finnhittson/ee308/lab1/output amplifier.asc

C1: cap; .8p
C2: cap; 20n
C3: cap; 20n
C4: cap; 600p
C5: cap; 47p
D1: diode; 1N4148
D2: diode; 1N4148
Q1: npn; 2N3904
Q2: npn; 2N3904
Q3: pnp; 2N3906
Q6: npn; 2N3904
Q9: pnp; 2N3906
R1: res; 750
R2: res; {pos+1}
R3: res; 50
R4: res; 50
R5: res; 5k
R6: res; 723
R7: res; 13k
R8: res; 1k
R9: res; 5
R10: res; 5
R11: res; 1k
R12: res; 50
R13: res; {potVal - pos +1}
R14: res; 200
R15: res; 50
R16: res; 200
R17: res; 12
R18: res; 50
R19: res; 100k
R20: res; 825
R21: res; 175
V1: voltage; 12
V2: voltage; 12
V3: voltage; PULSE(-10m 10m 0 1n 1n 0.5u 1u)
Named nets: 0, out, in
.ac oct 100 1k 1Gig
(+)
(-)
0.5W
.step param pos 0 1k 100
.tran 0 20u 18u
.param potVal = 1k
.param pos = 0
.meas TRAN v_peak MAX V(out) FROM 0 TO 0.1u
.meas TRAN v_final AVG V(out) FROM 0.2u TO 0.4u
.meas TRAN v_initial AVG V(out) FROM 0.8u TO 1u
.meas TRAN overshoot PARAM (v_peak-v_final)/(v_final-v_initial)*100
.meas TRAN avg_val AVG V(out)
PULSE(-10m 10m 0 1n 1n 0.5u 1u)
