finnhittson/ee308/lab2/schmitt trigger.asc

D1: diode; 1N4148
D2: diode; 1N4148
D3: diode; 1N4148
D4: diode; 1N4148
D5: diode; 1N4148
D6: diode; 1N4148
D7: diode; 1N4148
D8: diode; 1N4148
D9: diode; 1N4148
D10: diode; 1N4148
D11: diode; 1N4148
D12: diode; 1N4148
D13: schottky; 1N5817
D14: schottky; 1N5817
Q1: npn; 2N3904
Q2: npn; 2N3904
Q3: pnp; 2N3906
Q4: pnp; 2N3906
Q5: npn; 2N3904
R1: res; 1k
R2: res; 1k
R3: res; 2k
R4: res; {Rdiff1}
R5: res; {Rdiff1}
R6: res; 8k
R8: res; 8k
R9: res; 33k
R10: res; {Rdiff2}
R11: res; {Rdiff2}
R12: res; 10k
R13: res; 500
R15: res; 10k
R16: res; 10k
Rload: res; 1k
V1: voltage; PULSE(-1 1 0 {0.5 /f} {0.5 /f} 0 {1/f})
V2: voltage; 12
V3: voltage; 12
Named nets: 0, out
.tran 0 20u 18u
.param f=1Meg
(+)
(-)
.param Rdiff2=2.7k
.param Rdiff1=4k
