finnhittson/ee308/lab3/integrator.asc

C1: cap; 20µ
C2: cap; 1.82µ
C3: cap; 180n
C4: cap; 17.8n
C5: cap; 1.5n
C6: cap; 150p
D1: diode; 1N4148
D2: diode; 1N4148
D3: diode; 1N4148
D4: diode; 1N4148
D5: diode
D7: diode
D8: diode; 1N4148
D9: diode; 1N4148
D10: diode; 1N4148
D11: diode; 1N4148
D12: diode; 1N4148
D13: diode; 1N4148
D14: diode; 1N4148
D15: diode; 1N4148
D16: diode; 1N4148
D17: diode; 1N4148
D18: schottky; 1N5817
D19: schottky; 1N5817
J2: njf; J310
J3: njf; J310
Q1: pnp; 2N3906
Q2: pnp; 2N3906
Q3: npn; 2N3904
Q4: npn; 2N3904
Q5: npn; 2N3904
Q6: npn; 2N3904
Q7: npn; 2N3904
Q8: pnp; 2N3906
Q9: pnp; 2N3906
Q10: npn
R1: res; {potTop}
R2: res; 750
R3: res; {potBot}
R4: res; 750
R5: res; 1k
R6: res; 13k
R7: res; 1k
R8: res; 13k
R9: res; 1k
R10: res; 2k
R11: res; 33k
R12: res; 10k
R13: res; 4k
R14: res; 4k
R15: res; 8k
R16: res; 10k
R17: res; 226.5
R18: res; 470
R19: res; 8k
R20: res; 10k
R21: res; 500
R22: res; 1k
R23: res; 2.7k
R24: res; 2.7k
R25: res; 1k
S1: sw
S2: sw
S3: sw
S4: sw
S5: sw
S6: sw
U1: LM741
V1: voltage; 12
V2: voltage; 12
V3: voltage; PULSE(-1 1 0 1n 1n {T/2} {T})
V4: voltage; {SwitchPosition==1}
V5: voltage; {SwitchPosition==2}
V6: voltage; {SwitchPosition==3}
V7: voltage; {SwitchPosition==4}
V8: voltage; {SwitchPosition==5}
V9: voltage; {SwitchPosition==6}
Named nets: 0, square, tri_pre, SW1Ctrl, SW2Ctrl, SW3Ctrl, SW4Ctrl, SW5Ctrl, SW6Ctrl, tri, bing, tri_fb, sqr_fb
.param pot=100
.tran 0 {10*T} {8*T}
.param SwitchPosition=1
.model SW SW(Ron=1m Roff=10Meg Vt=0.5)
.param decade= 10**(SwitchPosition)*2
.param freq=decade-(decade-prevDecade)/100*(100-pot)
.param T=1/freq
.param potTop=10k-(100-pot)/100*10k+1
.param potBot=(100-pot)/100*10k+1
.param prevDecade=10**(SwitchPosition-1)*2
.meas tran T1 find time when V(triangle)=0 rise=1
.meas tran T2 find time when V(triangle)=0 rise=2
.meas tran Frequency param 1/(T2-T1)
.option noopiter
measures the frequency
change these parameters
pot scales from 0 - 100%
switch positions are 1 - 6
DO NOT MODIFY THESE
.lib 1N5711.lib
2Hz - 20Hz
20Hz - 200Hz
200Hz - 2kHz
2kHz - 20kHz
20kHz - 200kHz
200kHz - 2MHz
.step param pot 0 100 50
tune this level shifter to make dc offset was 0
