finnhittson/ee308/lab4/sine-shaper.asc

I1: current; 1m
I2: current; 1m
Q1: npn; 2N3904
Q2: npn; 2N3904
Q3: npn; 2N3904
Q4: npn; 2N3904
Q5: npn; 2N3904
R1: res; 2.5k
R2: res; 1.7k
R4: res; 80
R6: res; 100
R7: res; 100
R8: res; 10k
R9: res; 10k
R10: res; 1k
R11: res; 515
R12: res; 1k
V1: voltage; PULSE(-0.5 0.5 0 {0.5/f} {0.5/f} 1p {1/f})
V2: voltage; 12
V3: voltage; 12
Named nets: 0, sin, tri, tri_aten, out
.param f=2Meg
.tran 0 {100/f} {98/f}
.four {f} V(out)
